simonschindler/E-Ink/Software/VSCODE/VMCB/src/Yosemite.png

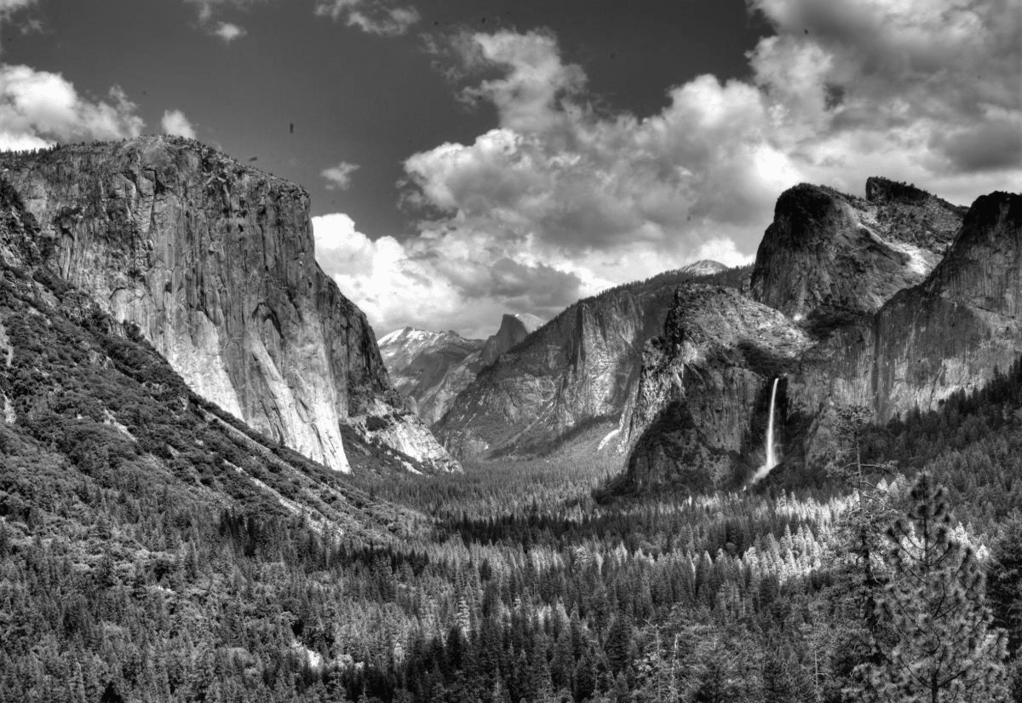
Software/VSCODE/VMCB/src/Yosemite.png
