simonschindler/E-Ink/Software/UML.png

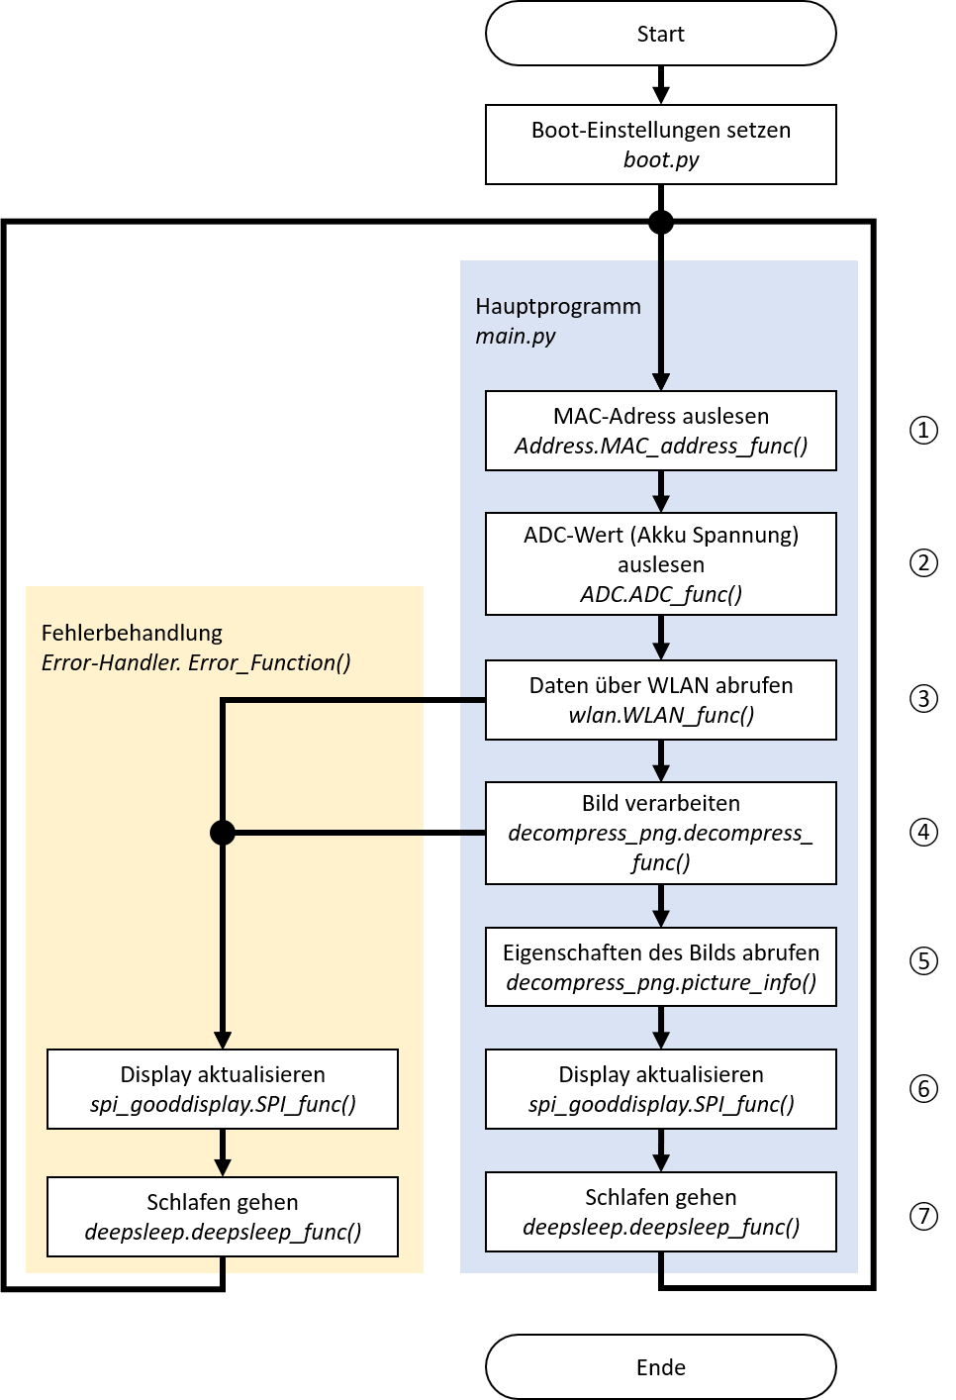
Software/UML.png
