simonschindler/E-Ink/Software/Wlan.png

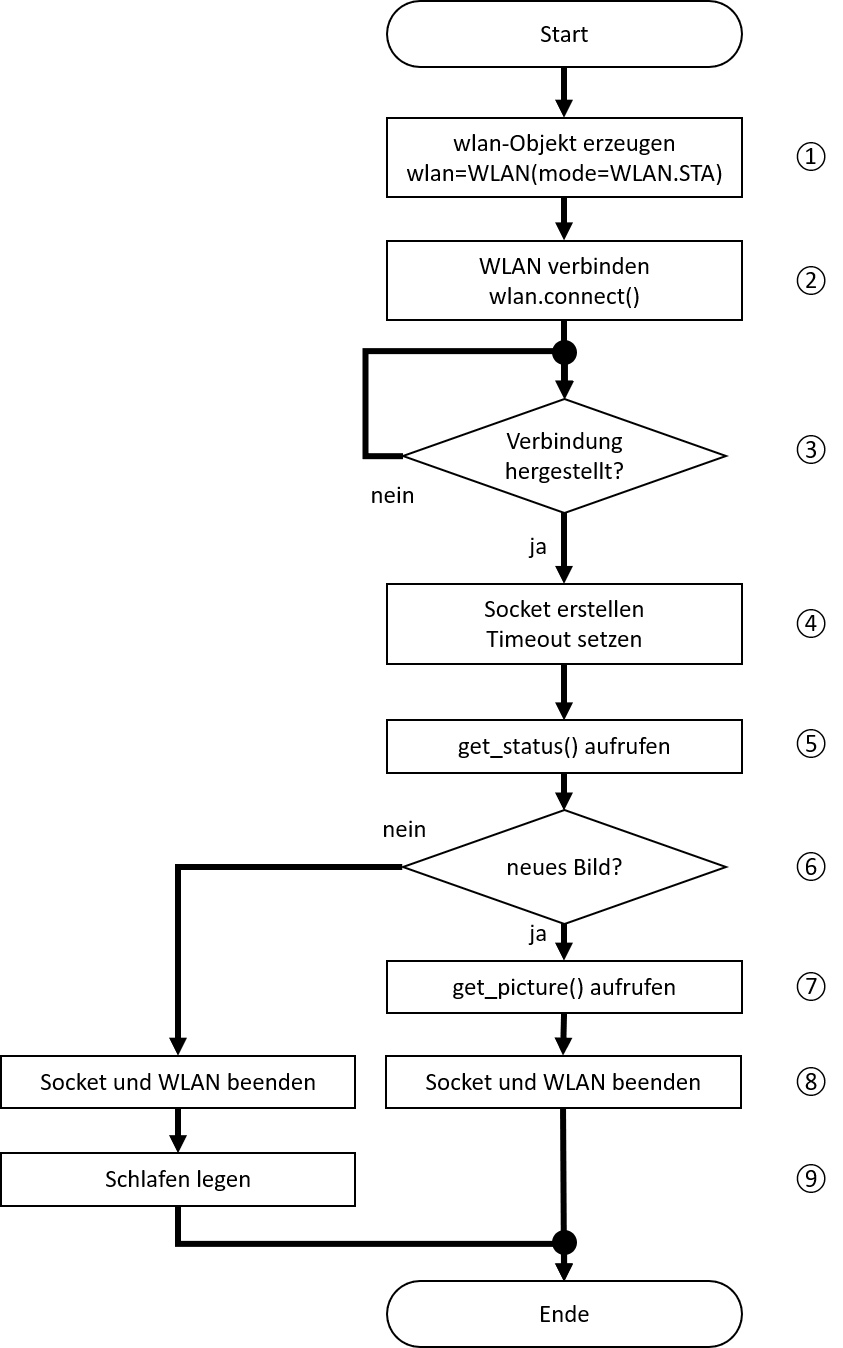
Software/Wlan.png
