simonschindler/E-Ink/Software/WlanSocket.png

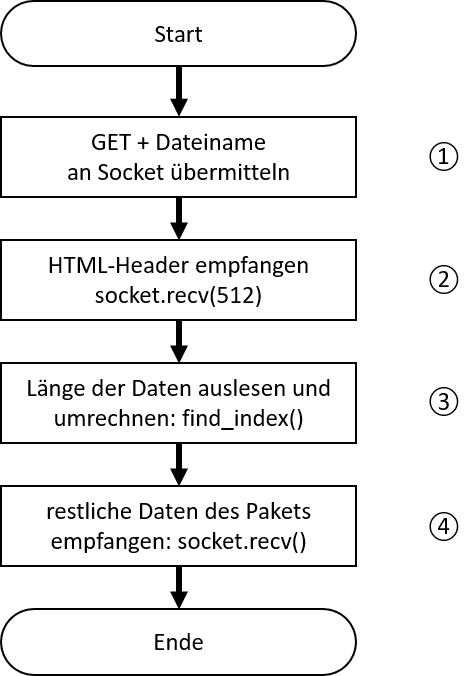
Software/WlanSocket.png
