simonschindler/E-Ink/Bestellliste.ods

Bauteilname | Distributor | Bestellnummer | Anzahl
ESP32-WROOM-32U | Digikey | 1904-1028-1-ND | 1
BuckBoost3V3 | Digikey | 296-39461-1-ND | 1
BuckBoost5V | Digikey | 296-19644-1-ND | 1
Spule 2.2 µH | Digikey | 490-15950-1-ND | 2
Level-Shifter | Digikey | 296-21929-1-ND | 1
Buchse zu E-Ink Driver | Digikey | 455-1755-1-ND | 1
Crimpkabel zu E-Ink Driver | Digikey | 455-3081-ND | 9
Stecker zu E-Ink Driver | Digikey | 455-1189-ND | 2
Button | Digikey | CW181-ND | 2
Transistor | Digikey | 1727-2921-1-ND | 1
Wifi-Antenne | Digikey | WM17566-ND | 1
Buchsenleiste | Digikey | S5438-ND | 2
für Gehäuse
Abstandshalter M3 Nylon (8,00mm) | Digikey | 36-25509-ND | 10
M3 Halbrundkopf Geschlitzt Nylon | Digikey | 36-29344-ND | 20
Battery Halter (offen) AA 3 Cell Drahtleitung - 6" (152,4mm) | Digikey | BH3AA-W-ND | 1
Battery Kontakt Lötöse | Digikey | 36-5223-ND | 2
Battery Kontaktfeder Lötöse | Digikey | 36-5201-ND | 2
Web-Kennung: |  | 307356988
Zugriffscode: |  | 91707
