simonschindler/E-Ink/Mechanics/Assembly.FCStd

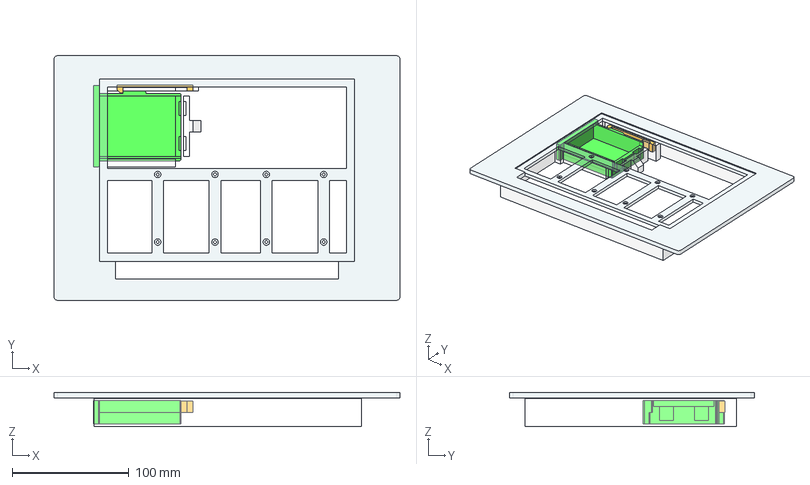
[picture p5: CAD file, 2020-03-20]
Mechanics/Assembly.FCStd
297.0 x 210.0 x 29.5 mm
Frontpanel_001
Verriegelungsstift_001
Batteriefach
Rückdeckel
