simonschindler/E-Ink/Hardware/E-Ink.step

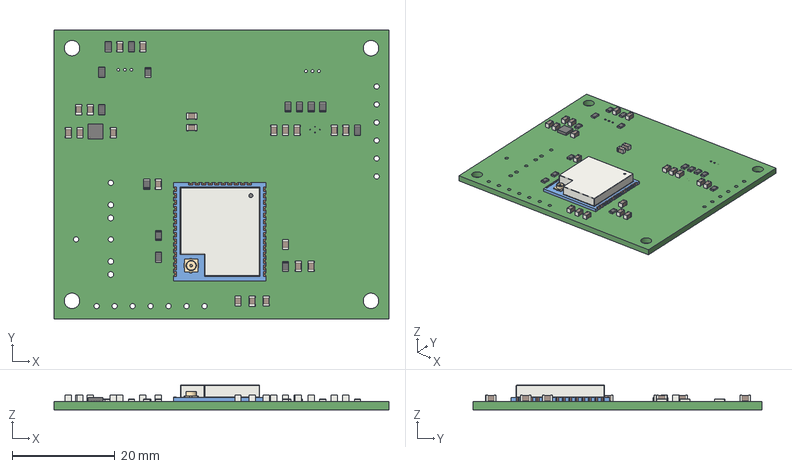
[picture p6: CAD file, 2019-12-15]
Hardware/E-Ink.step
65.2 x 56.2 x 4.85 mm
