simonschindler/E-Ink/Mechanics/Glasabdeckung.FCStd

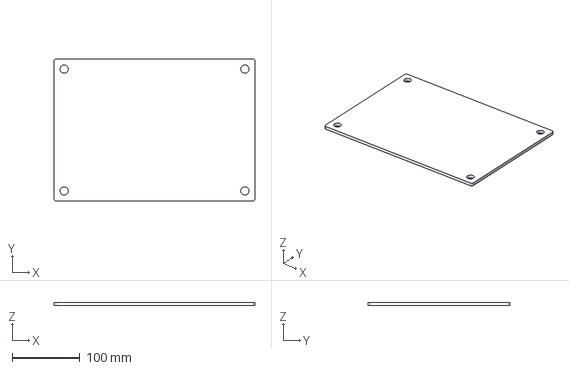
[picture p7: CAD file, 2020-12-21]
Mechanics/Glasabdeckung.FCStd
297.0 x 210.0 x 5.00 mm
