simonschindler/E-Ink/Mechanics/Wandhalterung_Zapfen.FCStd

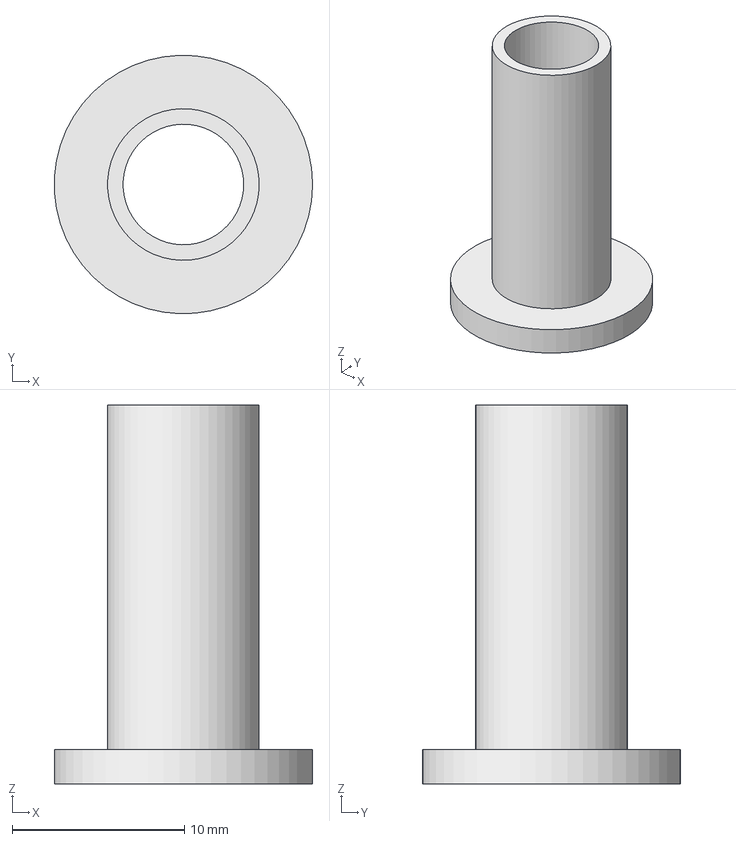
[picture p8: CAD file, 2020-12-18]
Mechanics/Wandhalterung_Zapfen.FCStd
15.0 x 15.0 x 22.0 mm
