simonschindler/E-Ink/Mechanics/Wandhalterung_Buchse.FCStd

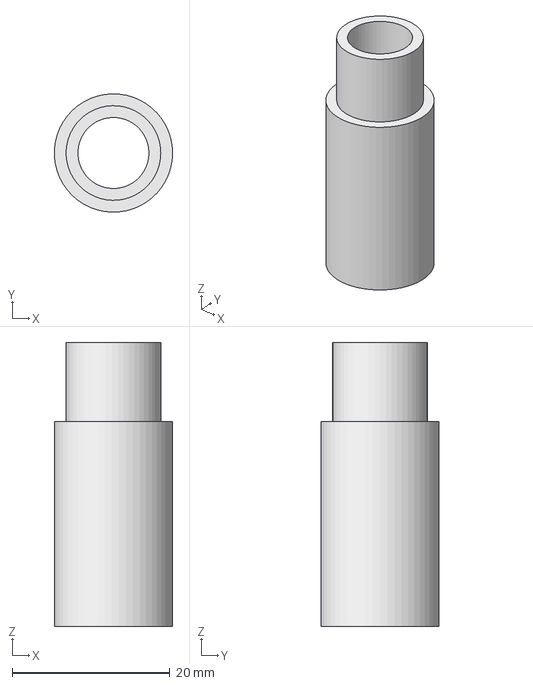
[picture p9: CAD file, 2020-12-18]
Mechanics/Wandhalterung_Buchse.FCStd
15.0 x 15.0 x 36.0 mm
