simonschindler/E-Ink/Mechanics/Frontpanel.FCStd

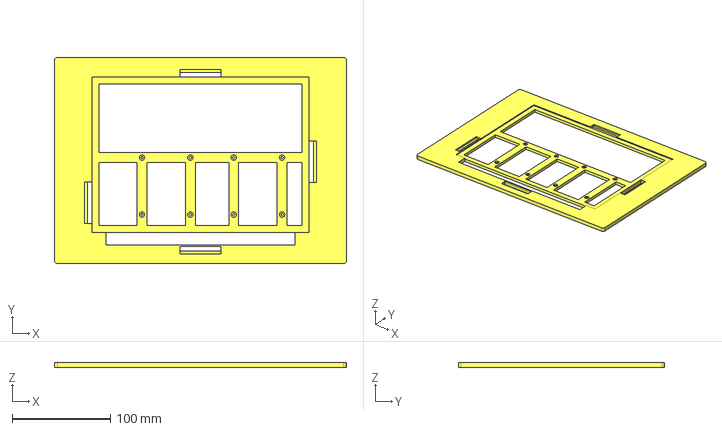
[picture p10: CAD file, 2020-07-03]
Mechanics/Frontpanel.FCStd
297.0 x 210.0 x 5.00 mm
