simonschindler/E-Ink/Mechanics/Rückdeckel.FCStd

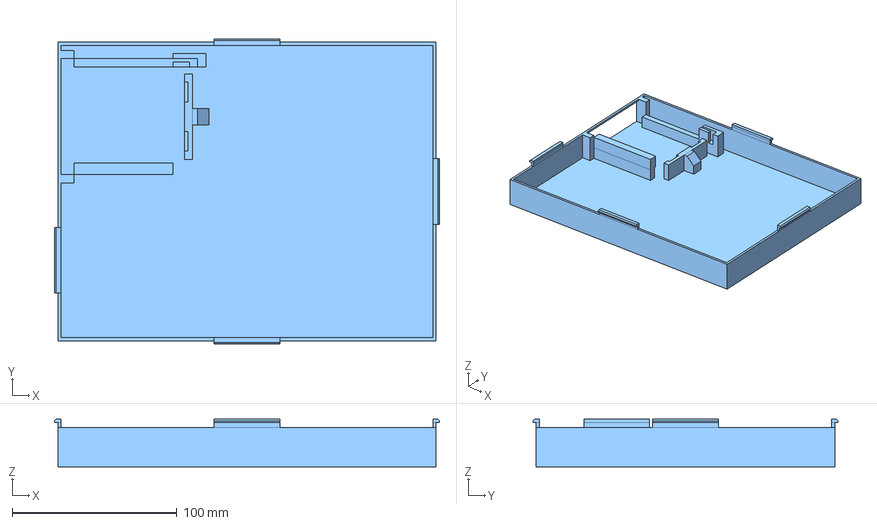
[picture p11: CAD file, 2020-05-02]
Mechanics/Rückdeckel.FCStd
234.0 x 185.5 x 29.0 mm
