simonschindler/E-Ink/Mechanics/Verriegelungsstift.FCStd

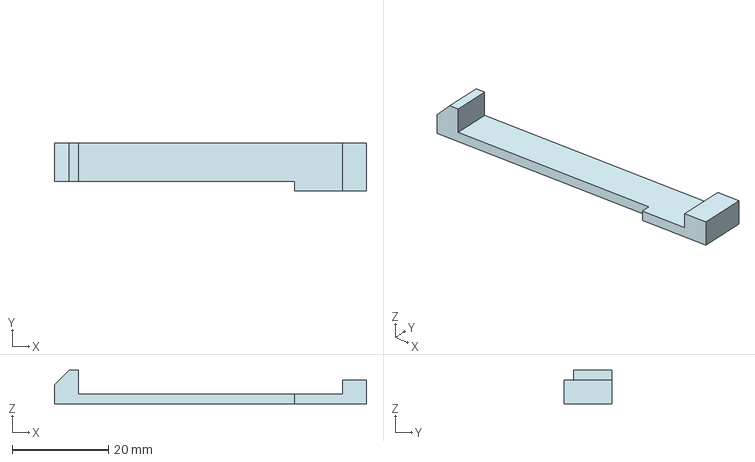
[picture p12: CAD file, 2020-05-02]
Mechanics/Verriegelungsstift.FCStd
65.0 x 10.0 x 7.00 mm
