simonschindler/E-Ink/Mechanics/Testaufbau montiert.FCStd

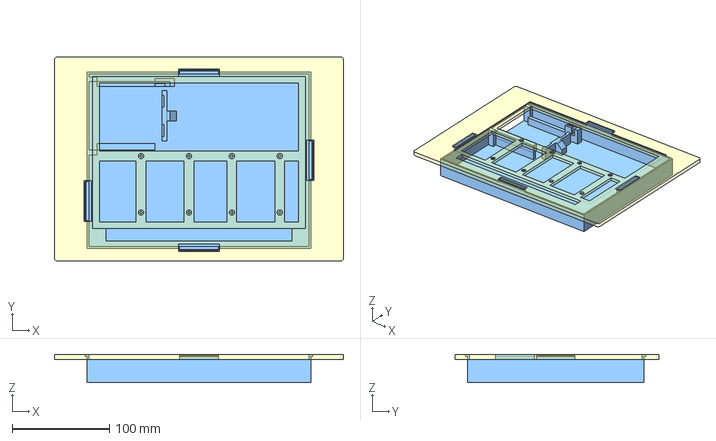
[picture p13: CAD file, 2020-05-02]
Mechanics/Testaufbau montiert.FCStd
297.0 x 210.0 x 29.0 mm
Grundmaße
