simonschindler/E-Ink/Mechanics/Testdeckel.FCStd

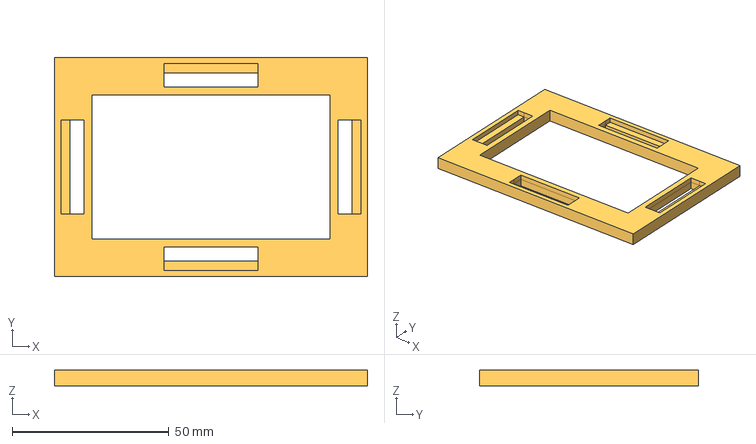
[picture p14: CAD file, 2020-03-20]
Mechanics/Testdeckel.FCStd
100.0 x 70.0 x 5.00 mm
