simonschindler/E-Ink/Mechanics/Testrückdeckel.FCStd

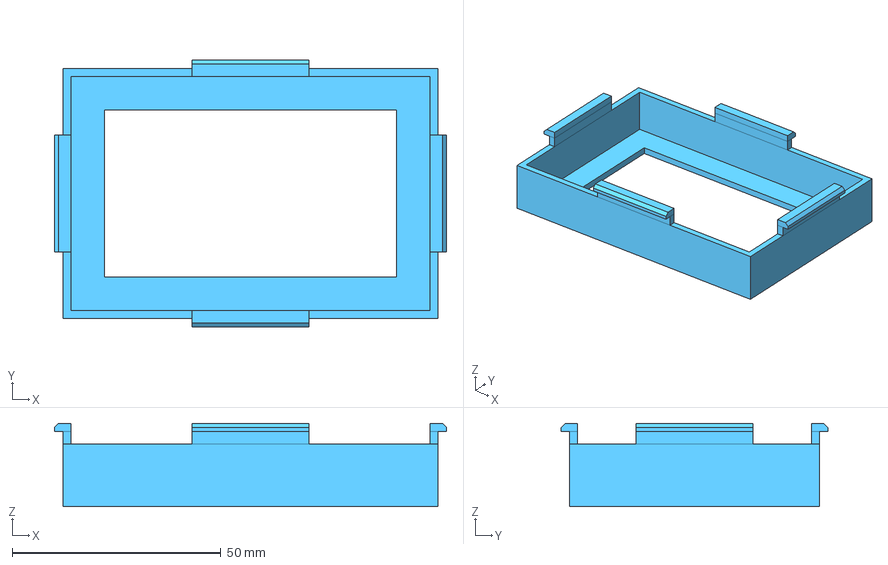
[picture p15: CAD file, 2020-03-20]
Mechanics/Testrückdeckel.FCStd
94.0 x 64.0 x 20.0 mm
