simonschindler/E-Ink/Mechanics/Batteriefach.FCStd

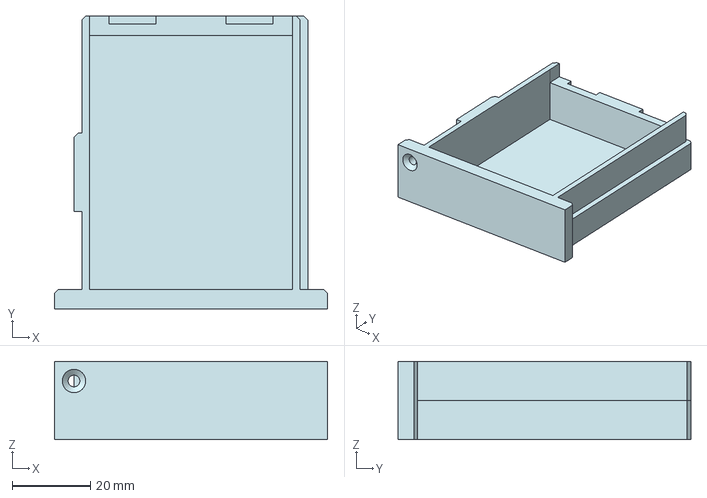
[picture p16: CAD file, 2020-03-20]
Mechanics/Batteriefach.FCStd
70.0 x 75.0 x 20.0 mm
