simonschindler/E-Ink/Errata_Platine.xlsx

Problembeschreibung | Bauteil | Lösung | Änderungsvorschlag
Levelshifter war unnötig, da IT8951 mit 3V3 Logik arbeitet | SPI-Levelshifter U501 | Levelshifter nicht bestücken, Verbindungen überbrücken | Levelshifter weglassen, Verbindungen durchziehen
Transistorschaltung funktioniert nicht, Ohne Transistor lässt sich der Eingang auch Enablen | Transistor Q201 | Transisitor entfernen, R201 u R202 kurzschließen | Transistor entfernen, EN direkt durchführen
Transistorschaltung funktioniert nicht | Transistor Q301 | Transisitor, R301 u R302 entfernen, R303 u R304 zur Stromsparenden Spannungsmessung mit 2.5 MegOhm bestücken | Transisitor, R301 u R302 entfernen, R303 u R304 zur Stromsparenden Spannungsmessung mit 2.5 MegOhm bestücken
