simonschindler/E-Ink/Hardware/E-Ink.kicad_pcb

## KiCad design Hardware/E-Ink.kicad_pcb (2020-12-18)

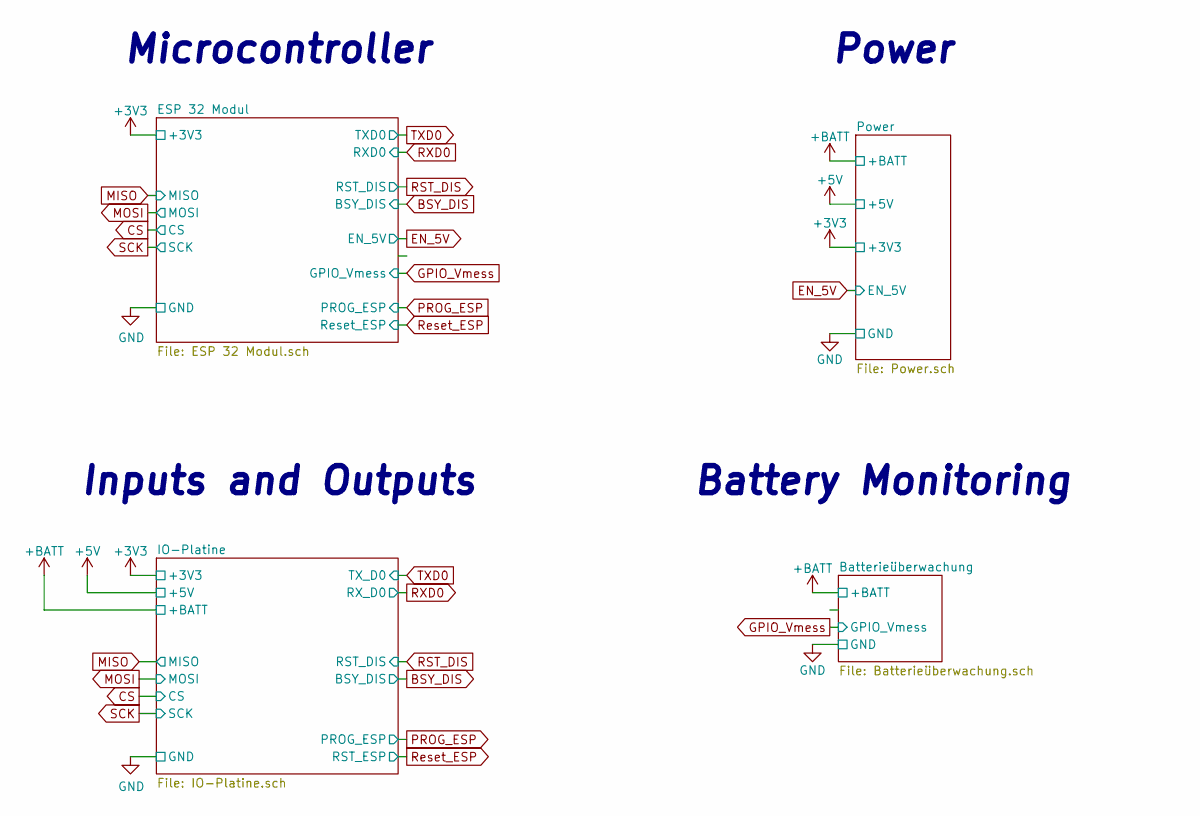
[picture p17: schematic E-Ink.sch, E-Ink-Parkplatzanzeige]

Notes on the sheet:
Microcontroller
Power
Inputs and Outputs
Battery Monitoring

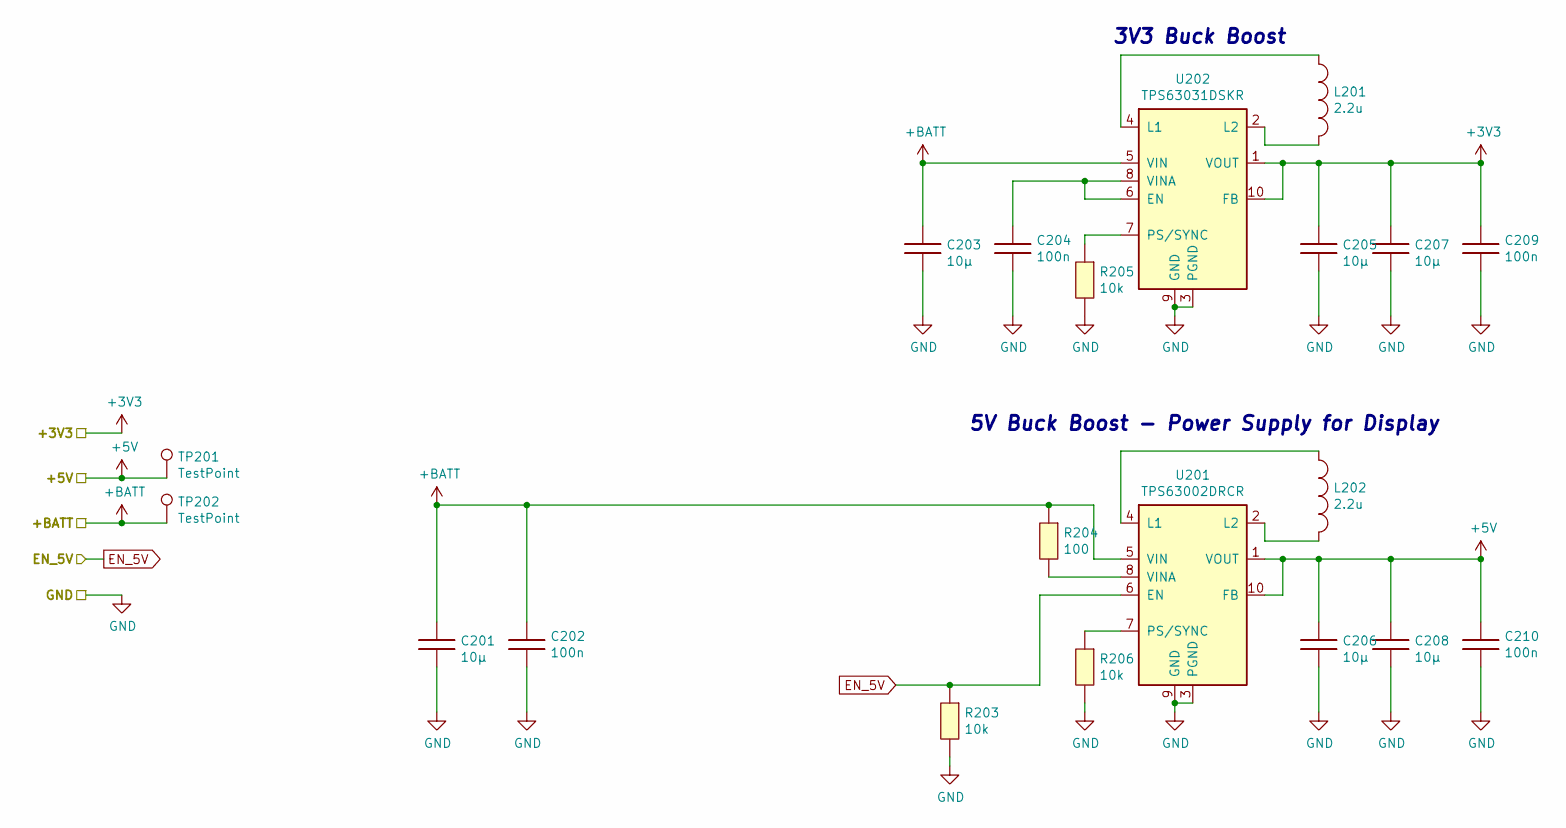
[picture p18: schematic Power.sch, E-Ink-Parkplatzanzeige]

Parts:
C201, C203, C205, C206, C207, C208: 10µ; C_0805_2012Metric_Pad1.15x1.40mm_HandSolder
C202, C204, C209, C210: 100n; C_0805_2012Metric_Pad1.15x1.40mm_HandSolder
L201, L202: 2.2u; L_Taiyo-Yuden_MD-3030; Digi-Key_PN 490-15950-1-ND
R203, R205, R206: 10k; R_0805_2012Metric_Pad1.15x1.40mm_HandSolder
R204: 100; R_0805_2012Metric_Pad1.15x1.40mm_HandSolder
TP201, TP202: TestPoint; Test_Point_D1.02mm; Digi-Key_PN 36-5001-ND
U201: TPS63002DRCR; Texas_DRC0010J_ThermalVias; Digi-Key_PN 296-19644-1-ND
U202: TPS63031DSKR; WSON-8-1EP_3x3mm_P0.5mm_EP1.6x2.0mm; Digi-Key_PN 296-39461-1-ND

Connections:
+3V3: C205.1, C207.1, C209.1, U202.1 (VOUT), U202.10 (FB); also elsewhere on the board
+5V: C206.1, C208.1, C210.1, TP201.1, U201.1 (VOUT), U201.10 (FB); also elsewhere on the board
+BATT: C201.1, C202.1, C203.1, R204.1, TP202.1, U201.5 (VIN), U202.5 (VIN); also elsewhere on the board
EN_5V: R203.1, U201.6 (EN); also elsewhere on the board
GND: C201.2, C202.2, C203.2, C204.2, C205.2, C206.2, C207.2, C208.2, C209.2, C210.2, R203.2, R205.2, R206.2, U201.3 (PGND), U201.9 (GND), U201.11 (PGND), U202.3 (PGND), U202.9 (GND), U202.11 (PGND); also elsewhere on the board
unnamed: C204.1, U202.6 (EN), U202.8 (VINA)
unnamed: L201.1, U202.4 (L1)
unnamed: L201.2, U202.2 (L2)
unnamed: L202.1, U201.4 (L1)
unnamed: L202.2, U201.2 (L2)
unnamed: R204.2, U201.8 (VINA)
unnamed: R205.1, U202.7 (PS/SYNC)
unnamed: R206.1, U201.7 (PS/SYNC)

Notes on the sheet:
3V3 Buck Boost
5V Buck Boost - Power Supply for Display

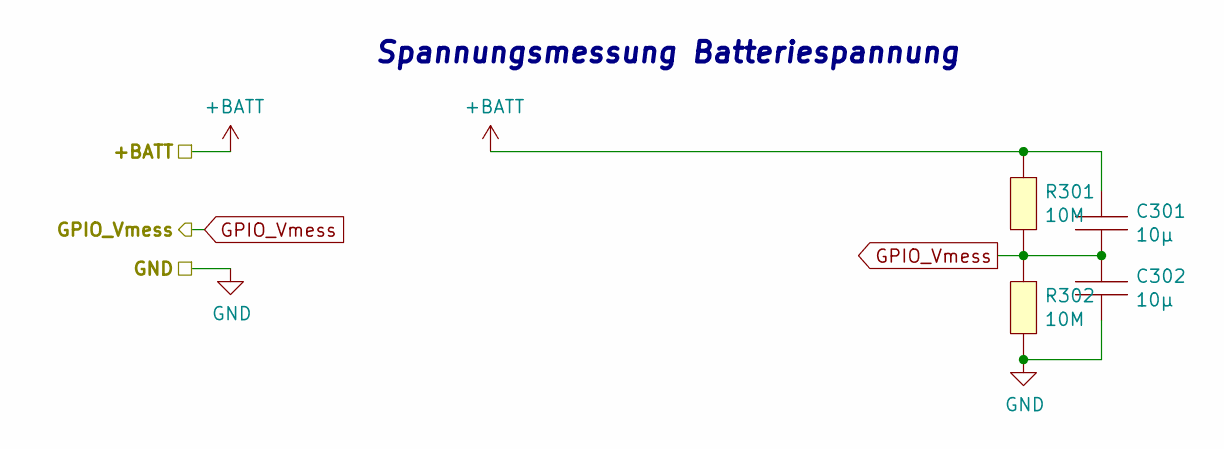
[picture p19: schematic Batterieüberwachung.sch, E-Ink-Parkplatzanzeige]

Parts:
C301, C302: 10µ; C_0805_2012Metric_Pad1.15x1.40mm_HandSolder
R301, R302: 10M; R_0805_2012Metric_Pad1.20x1.40mm_HandSolder

Connections:
+BATT: C301.1, R301.2; also elsewhere on the board
GND: C302.2, R302.2; also elsewhere on the board
GPIO_Vmess: C301.2, C302.1, R301.1, R302.1; also elsewhere on the board

Notes on the sheet:
Spannungsmessung Batteriespannung

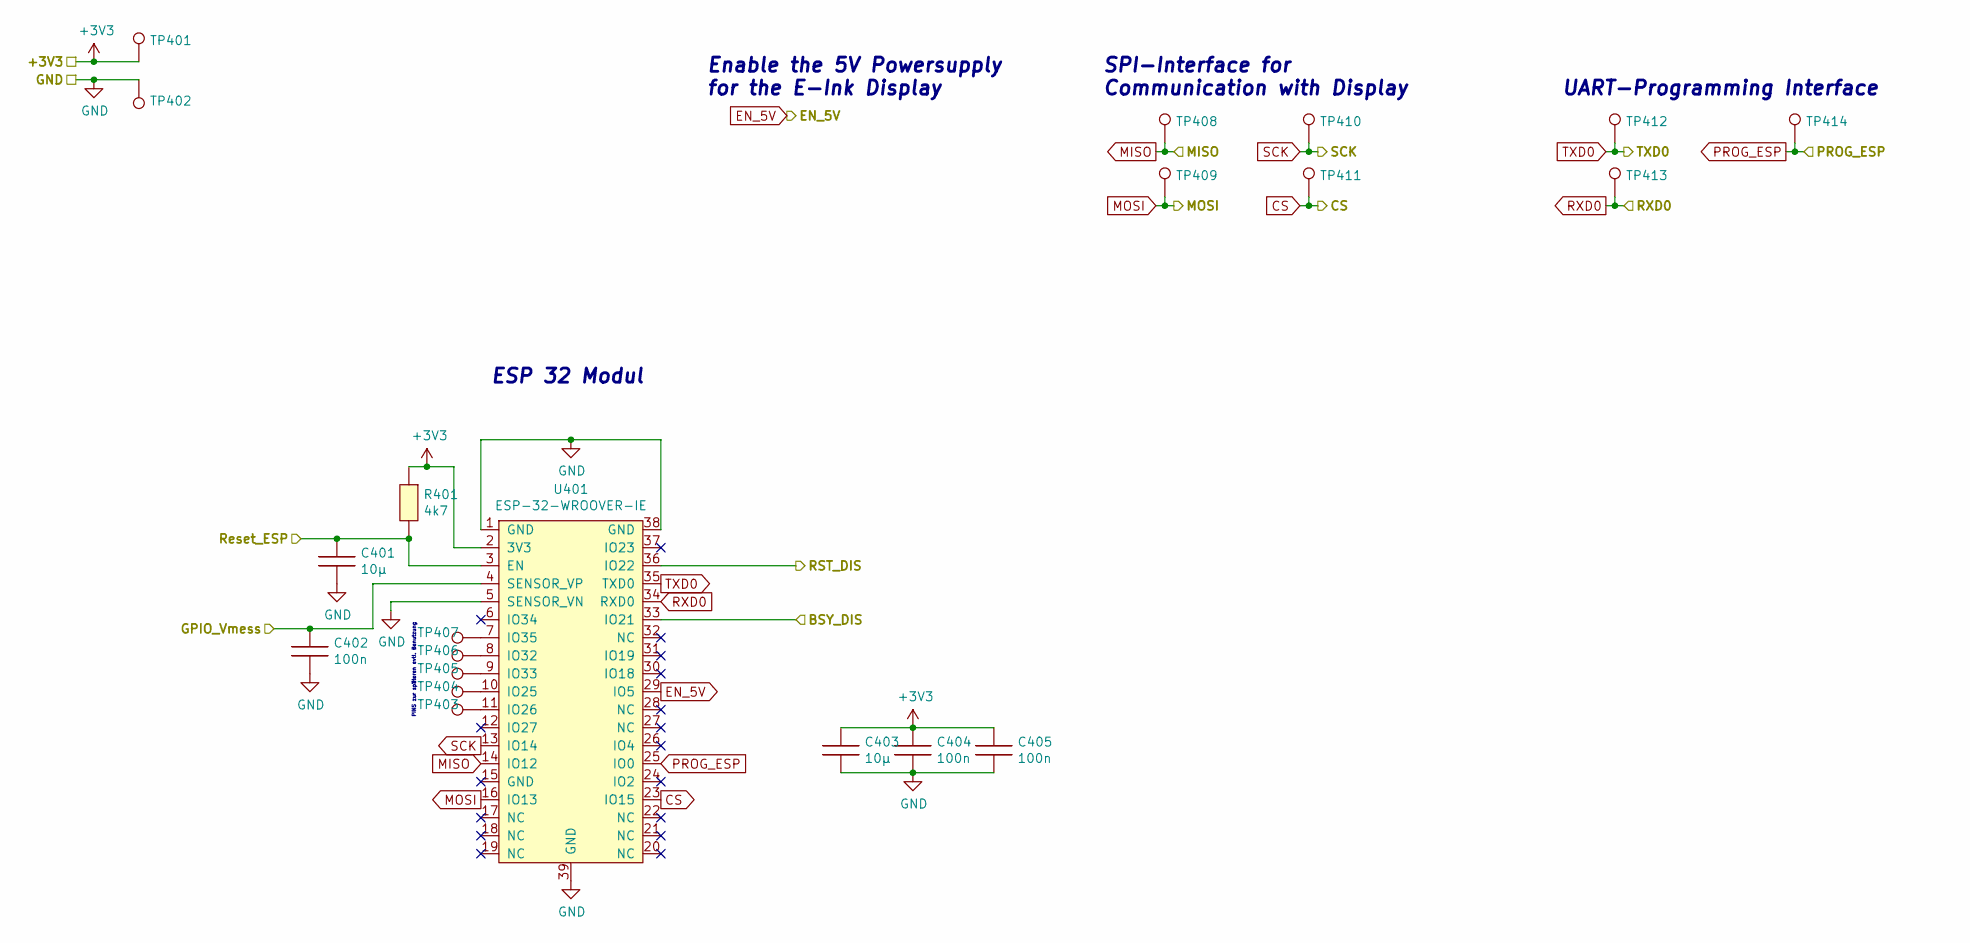
[picture p20: schematic ESP 32 Modul.sch, E-Ink-Parkplatzanzeige]

Parts:
C401, C403: 10µ; C_0805_2012Metric_Pad1.15x1.40mm_HandSolder
C402, C404, C405: 100n; C_0805_2012Metric_Pad1.15x1.40mm_HandSolder
R401: 4k7; R_0805_2012Metric_Pad1.15x1.40mm_HandSolder
TP401, TP402, TP403, TP404, TP405, TP406, TP407, TP408, TP409, TP410, TP411, TP412, TP413, TP414: TestPoint; Test_Point_D1.02mm; Digi-Key_PN 36-5001-ND
U401: ESP-32-WROOVER-IE; ESP32-WROVER

Connections:
+3V3: C403.1, C404.1, C405.1, R401.1, TP401.1, U401.2 (3V3); also elsewhere on the board
BSY_DIS: U401.33 (IO21); also elsewhere on the board
CS: TP411.1, U401.23 (IO15); also elsewhere on the board
EN_5V: U401.29 (IO5); also elsewhere on the board
GND: C401.2, C402.2, C403.2, C404.2, C405.2, TP402.1, U401.1 (GND), U401.5 (SENSOR_VN), U401.38 (GND), U401.39 (GND); also elsewhere on the board
GPIO_Vmess: C402.1, U401.4 (SENSOR_VP); also elsewhere on the board
MISO: TP408.1, U401.14 (IO12); also elsewhere on the board
MOSI: TP409.1, U401.16 (IO13); also elsewhere on the board
unnamed: TP403.1, U401.11 (IO26)
unnamed: TP404.1, U401.10 (IO25)
unnamed: TP405.1, U401.9 (IO33)
unnamed: TP406.1, U401.8 (IO32)
unnamed: TP407.1, U401.7 (IO35)
PROG_ESP: TP414.1, U401.25 (IO0); also elsewhere on the board
RST_DIS: U401.36 (IO22); also elsewhere on the board
RST_ESP: C401.1, R401.2, U401.3 (EN); also elsewhere on the board
RXD0: TP413.1, U401.34 (RXD0); also elsewhere on the board
SCK: TP410.1, U401.13 (IO14); also elsewhere on the board
TXD0: TP412.1, U401.35 (TXD0); also elsewhere on the board

Notes on the sheet:
ESP 32 Modul
UART-Programming Interface
SPI-Interface for Communication with Display
Enable the 5V Powersupply for the E-Ink Display
PINS zur späteren evtl. Benutzung

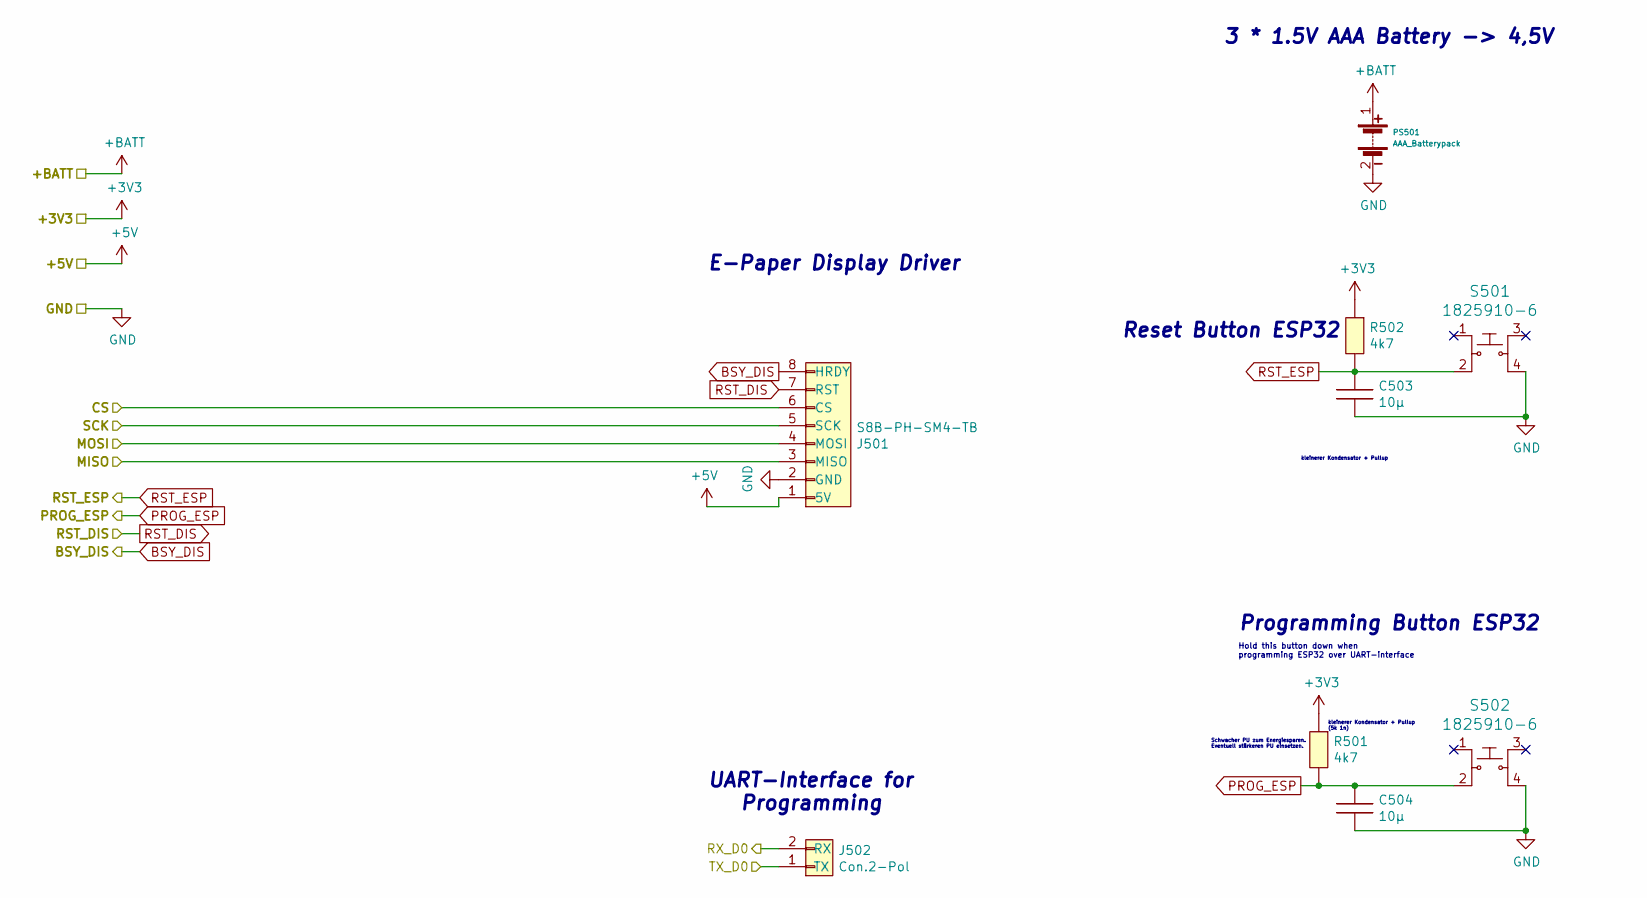
[picture p21: schematic IO-Platine.sch, E-Ink-Parkplatzanzeige]

Parts:
C503, C504: 10µ; C_0805_2012Metric_Pad1.15x1.40mm_HandSolder
J501: S8B-PH-SM4-TB; Digi-Key_PN 455-1755-1-ND
J502: Con.2-Pol; Pin-Header_1x2_2.54mm; Digi-Key_PN S5438-ND
PS501: AAA_Batterypack; Pin-Header_1x2_2.54mm
R501: 4k7; R_0805_2012Metric_Pad1.15x1.40mm_HandSolder
R502: 4k7; R_0805_2012Metric_Pad1.20x1.40mm_HandSolder
S501, S502: 1825910-6; Switch_Tactile_SMD_6x6mm; MPN 1825910-6; Digi-Key_PN 450-1650-ND

Connections:
+3V3: R501.1, R502.1; also elsewhere on the board
+5V: J501.1 (5V); also elsewhere on the board
+BATT: PS501.1; also elsewhere on the board
BSY_DIS: J501.8 (HRDY); also elsewhere on the board
CS: J501.6 (CS); also elsewhere on the board
GND: C503.2, C504.2, J501.2 (GND), PS501.2, S501.4, S502.4; also elsewhere on the board
MISO: J501.3 (MISO); also elsewhere on the board
MOSI: J501.4 (MOSI); also elsewhere on the board
PROG_ESP: C504.1, R501.2, S502.2; also elsewhere on the board
RST_DIS: J501.7 (RST); also elsewhere on the board
RST_ESP: C503.1, R502.2, S501.2; also elsewhere on the board
RXD0: J502.2 (RX); also elsewhere on the board
SCK: J501.5 (SCK); also elsewhere on the board
TXD0: J502.1 (TX); also elsewhere on the board

Notes on the sheet:
Reset Button ESP32
Programming Button ESP32
Schwacher PU zum Energiesparen. Eventuell stärkeren PU einsetzen.
Hold this button down when programming ESP32 over UART-interface
E-Paper Display Driver
3 * 1.5V AAA Battery -> 4,5V
UART-Interface for Programming
kleinerer Kondensator + Pullup
kleinerer Kondensator + Pullup (5k 1n)

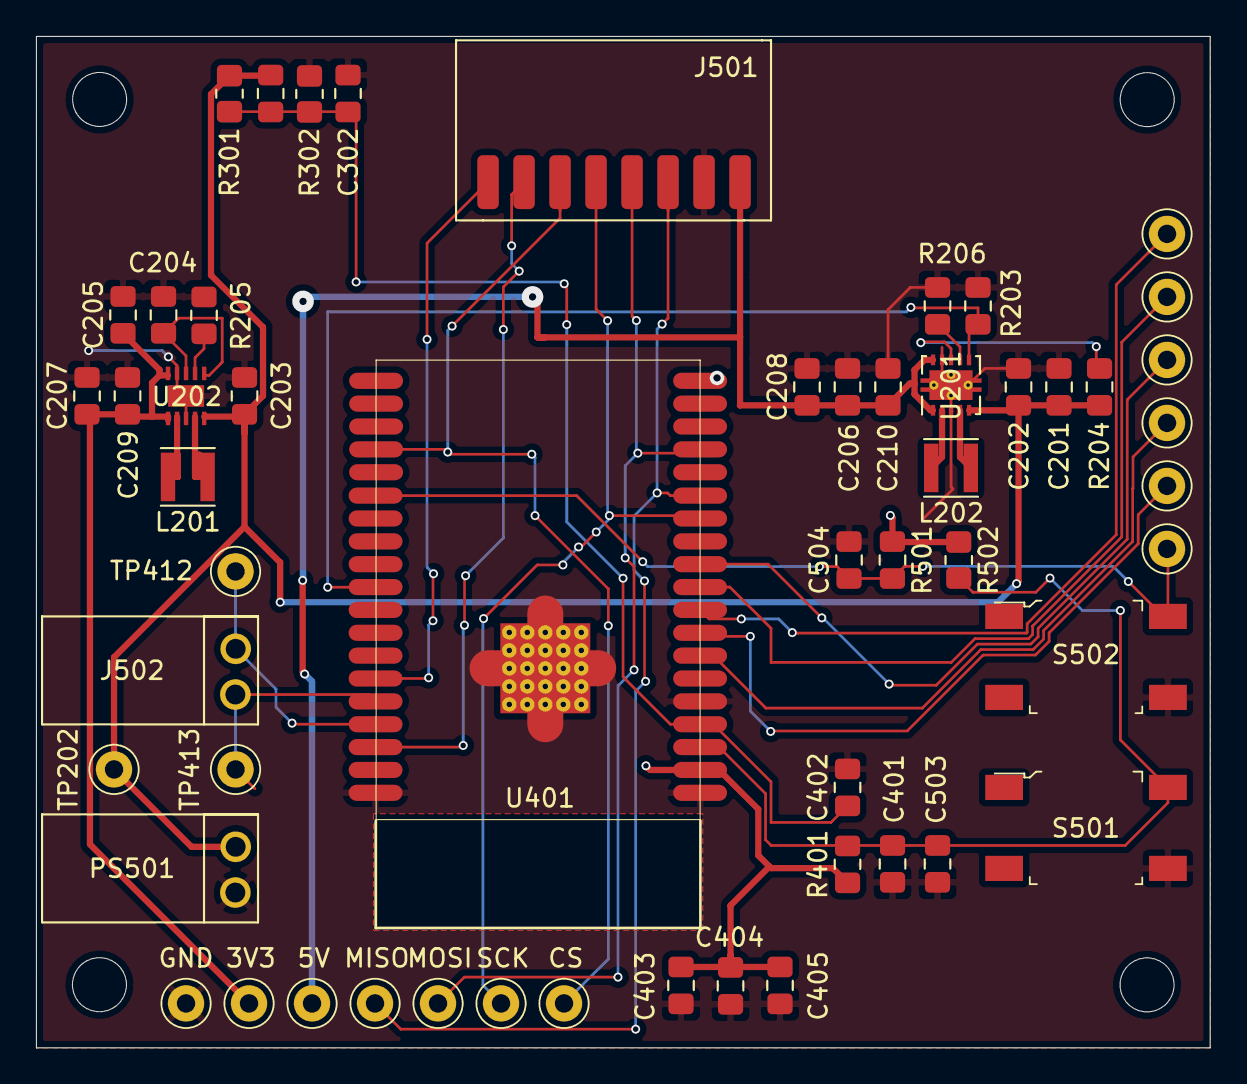
[picture p22: board E-Ink.kicad_pcb from above]

Board: 2 copper layers, 65.2 x 56.2 mm, 54 parts (0 on the bottom side), 29 nets.
