simonschindler/E-Ink/Pavel/Tuerschild_Boarddesign.kicad_pcb

## KiCad design Pavel/Tuerschild_Boarddesign.kicad_pcb (2019-11-27)

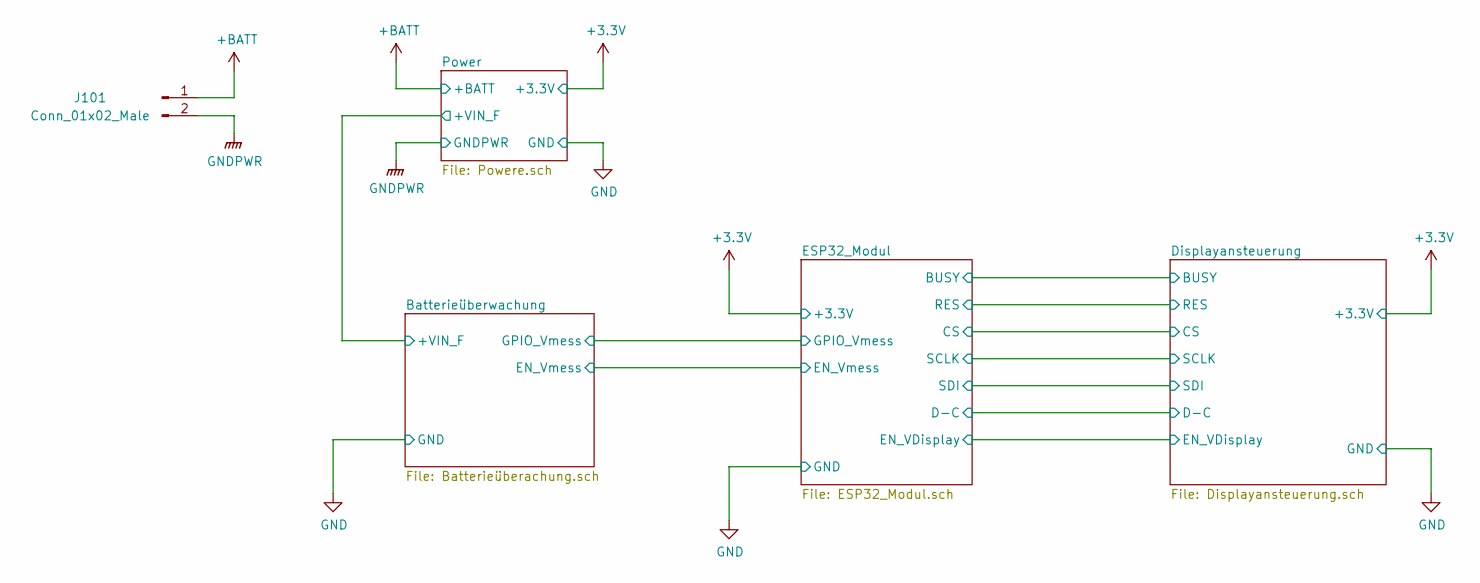
[picture p23: schematic Tuerschild_Boarddesign.sch]

Parts:
J101: Conn_01x02_Male; Batterieeinspeisungspads

Connections:
+BATT: J101.1; also elsewhere on the board
GNDPWR: J101.2; also elsewhere on the board

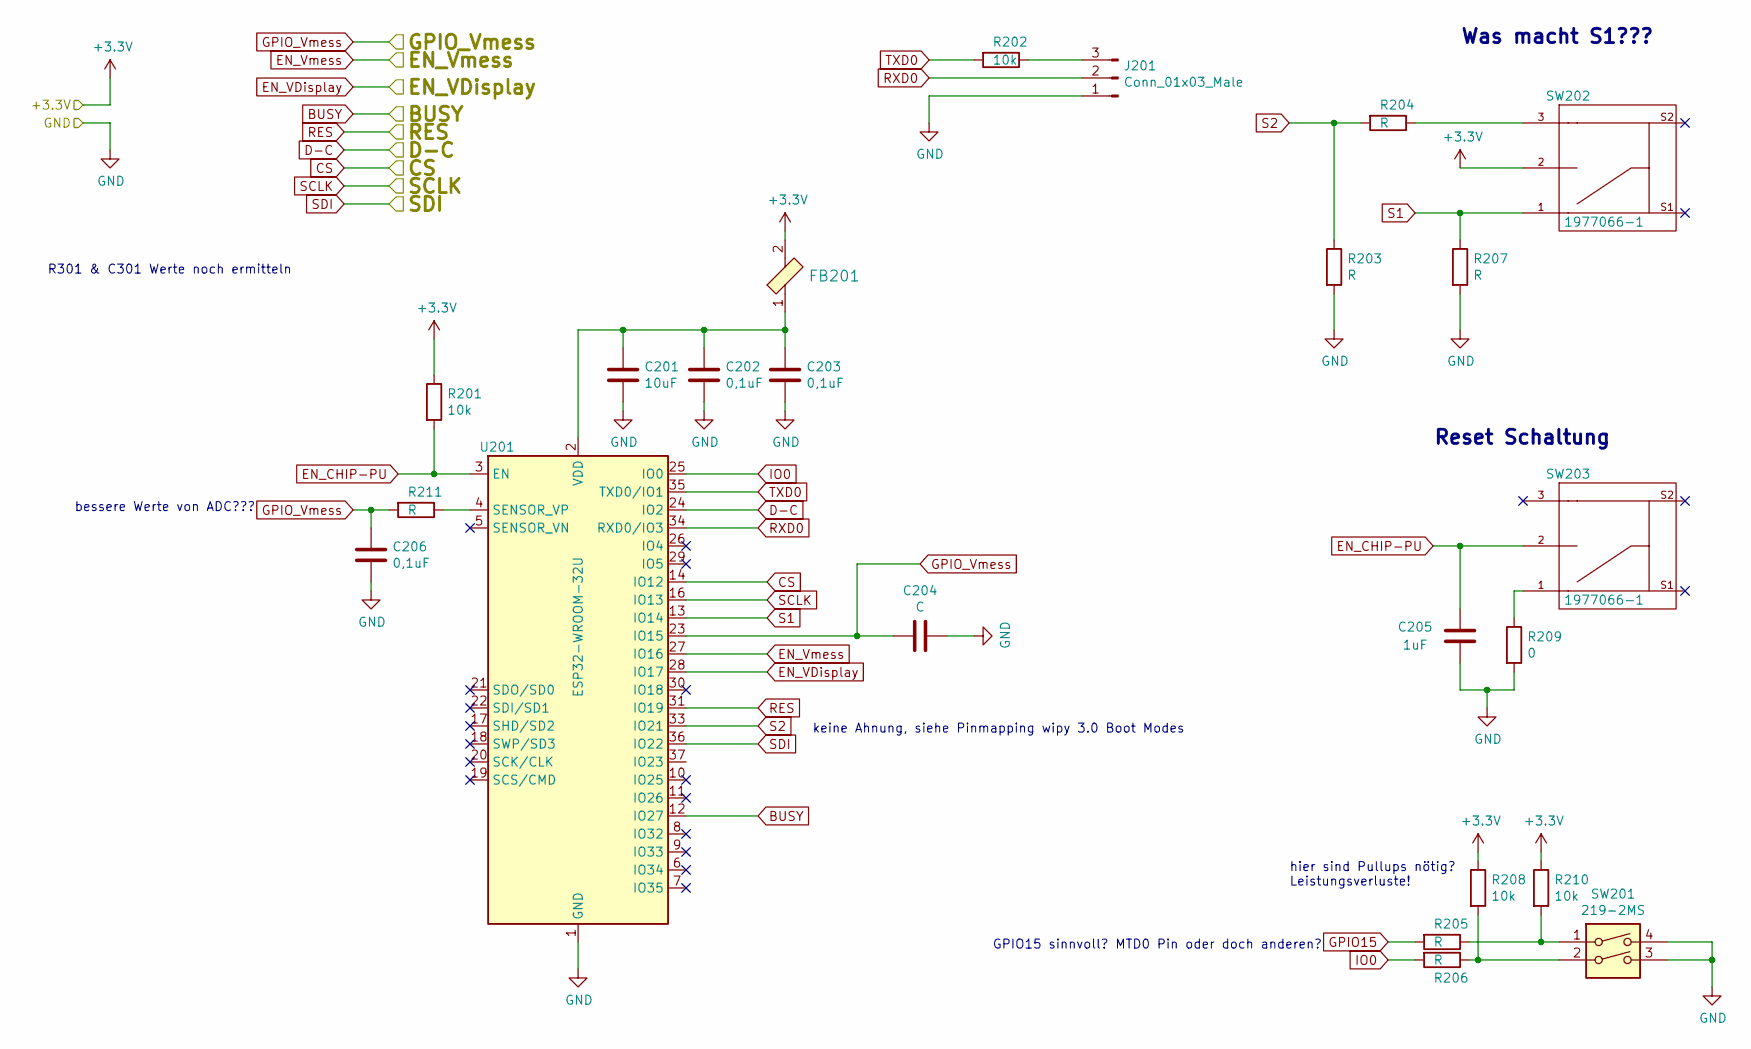
[picture p24: schematic ESP32_Modul.sch]

Parts:
C201: 10uF; C_0603_1608Metric
C202, C203, C206: 0,1uF; C_0603_1608Metric
C204: C; C_0603_1608Metric
C205: 1uF; C_0603_1608Metric
FB201: 742792641; 0603; MPN 742792641; Digi-Key_PN 732-1592-2-ND
J201: Conn_01x03_Male; FanPinHeader_1x03_P2.54mm_Vertical
R201, R202, R208, R210: 10k; R_0603_1608Metric_Pad1.05x0.95mm_HandSolder
R203, R204, R205, R206, R207, R211: R; R_0603_1608Metric_Pad1.05x0.95mm_HandSolder
R209: 0; R_0603_1608Metric_Pad1.05x0.95mm_HandSolder
SW201: 219-2MS; SW_DIP_SPSTx02_Slide_6.7x6.64mm_W8.61mm_P2.54mm_LowProfile
SW202, SW203: 1977066-1; TE_1977066-1
U201: ESP32-WROOM-32U

Connections:
+3V3: FB201.2, R201.1, R208.1, R210.1, SW202.2; also elsewhere on the board
BUSY: U201.12 (IO27); also elsewhere on the board
CS: U201.14 (IO12); also elsewhere on the board
D-C: U201.24 (IO2); also elsewhere on the board
EN_CHIP-PU: C205.2, R201.2, SW203.2, U201.3 (EN)
EN_VDisplay: U201.28 (IO17); also elsewhere on the board
EN_Vmess: U201.27 (IO16); also elsewhere on the board
GND: C201.2, C202.2, C203.2, C204.1, C205.1, C206.2, J201.1, R203.2, R207.2, R209.2, SW201.3, SW201.4, U201.1 (GND), U201.15 (GND), U201.38 (GND); also elsewhere on the board
GPIO15: R205.2
GPIO_Vmess: C204.2, C206.1, R211.2, U201.23 (IO15); also elsewhere on the board
IO0: R206.2, U201.25 (IO0)
unnamed: C201.1, C202.1, C203.1, FB201.1, U201.2 (VDD)
unnamed: J201.3, R202.1
unnamed: R204.1, SW202.3 (1)
unnamed: R205.1, R210.2, SW201.1
unnamed: R206.1, R208.2, SW201.2
unnamed: R209.1, SW203.1
unnamed: R211.1, U201.4 (SENSOR_VP)
RES: U201.31 (IO19); also elsewhere on the board
RXD0: J201.2, U201.34 (RXD0/IO3)
S1: R207.1, SW202.1, U201.13 (IO14)
S2: R203.1, R204.2, U201.33 (IO21)
SCLK: U201.16 (IO13); also elsewhere on the board
SDI: U201.36 (IO22); also elsewhere on the board
TXD0: R202.2, U201.35 (TXD0/IO1)

Notes on the sheet:
R301 & C301 Werte noch ermitteln
Reset Schaltung
Was macht S1???
hier sind Pullups nötig? Leistungsverluste!
keine Ahnung, siehe Pinmapping wipy 3.0 Boot Modes
bessere Werte von ADC???
GPIO15 sinnvoll? MTD0 Pin oder doch anderen?

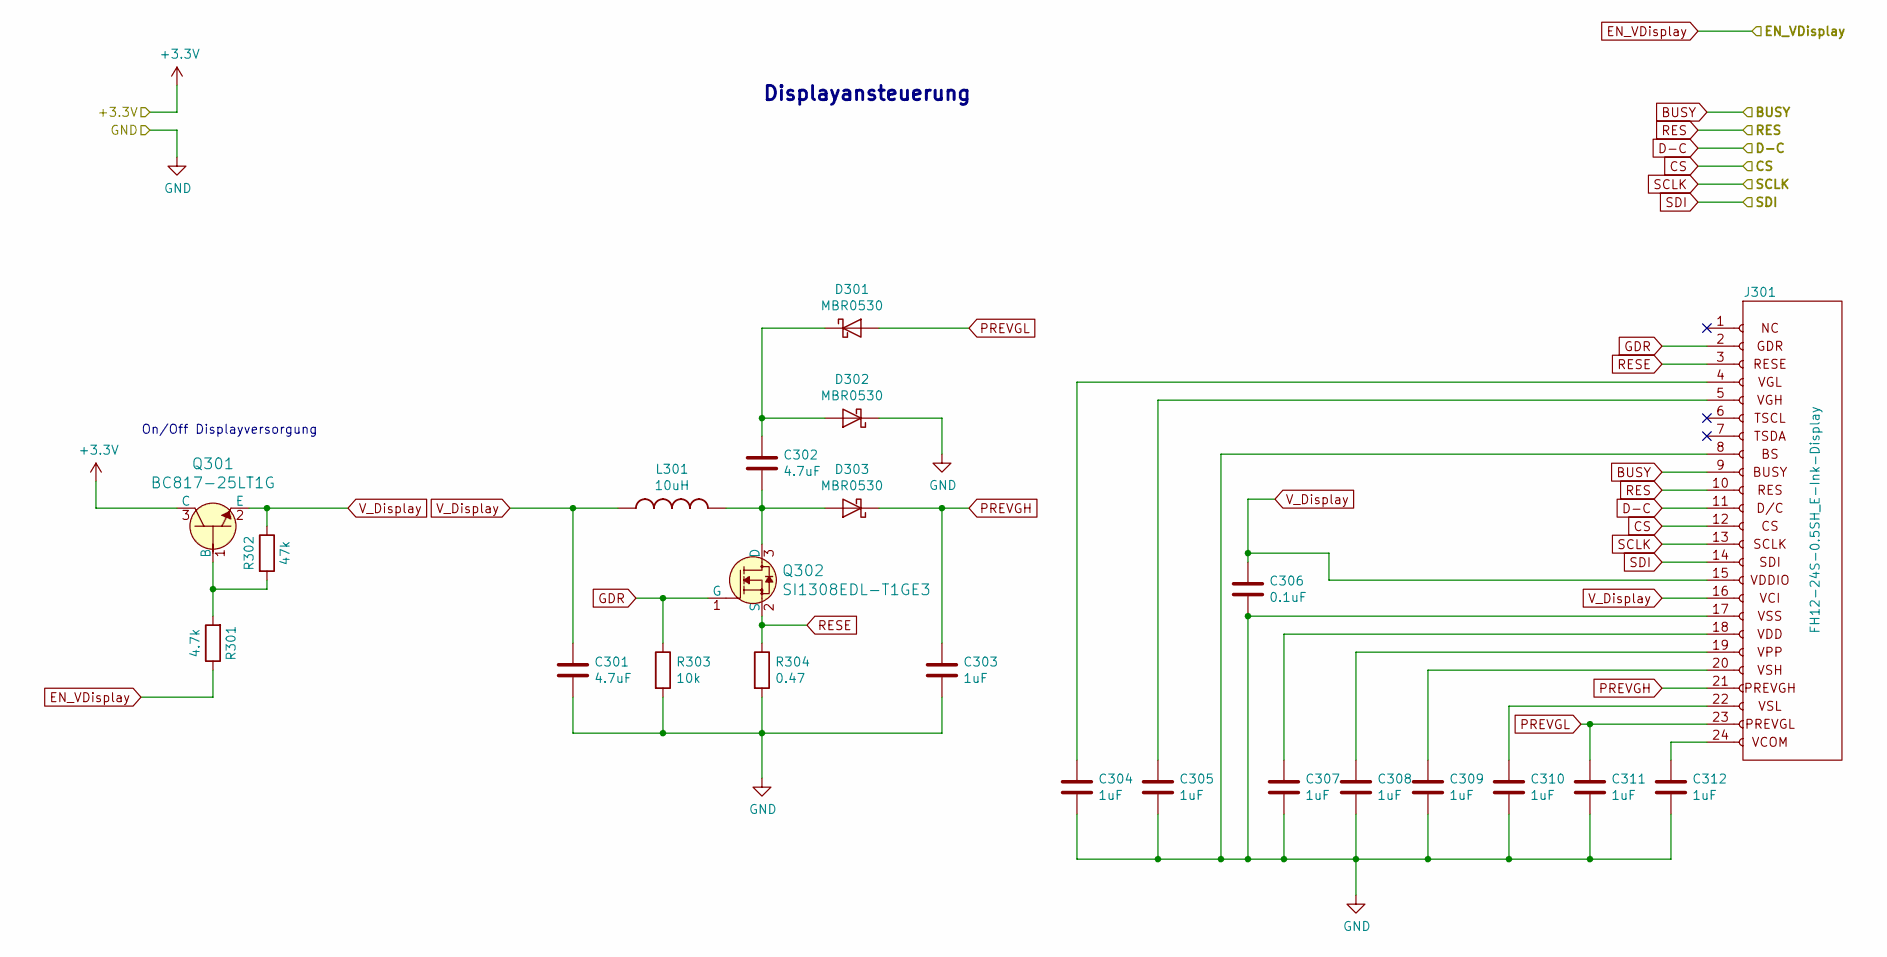
[picture p25: schematic Displayansteuerung.sch]

Parts:
C301, C302: 4.7uF; C_0603_1608Metric
C303, C304, C305, C307, C308, C309, C310, C311, C312: 1uF; C_0603_1608Metric
C306: 0.1uF; C_0603_1608Metric
D301, D302, D303: MBR0530; D_SOD-123
J301: FH12-24S-0.5SH_E-Ink-Display; Hirose_FH12-24S-0.5SH_1x24-1MP_P0.50mm_Horizontal
L301: 10uH; NLCV32-EF
Q301: BC817-25LT1G; SOT-23; MPN BC817-25LT1G; Digi-Key_PN BC817-25LT1GOSCT-ND
Q302: SI1308EDL-T1GE3; SOT-323_SC-70; MPN SI1308EDL-T1-GE3; Digi-Key_PN SI1308EDL-T1-GE3CT-ND
R301: 4.7k; R_0603_1608Metric_Pad1.05x0.95mm_HandSolder
R302: 47k; R_0603_1608Metric_Pad1.05x0.95mm_HandSolder
R303: 10k; R_0603_1608Metric_Pad1.05x0.95mm_HandSolder
R304: 0.47; R_0603_1608Metric_Pad1.05x0.95mm_HandSolder

Connections:
+3V3: Q301.3 (C); also elsewhere on the board
BUSY: J301.9; also elsewhere on the board
CS: J301.12; also elsewhere on the board
D-C: J301.11; also elsewhere on the board
EN_VDisplay: R301.1; also elsewhere on the board
GDR: J301.2, Q302.1 (G), R303.1
GND: C301.2, C303.2, C304.2, C305.2, C306.2, C307.2, C308.2, C309.2, C310.2, C311.2, C312.2, D302.1 (K), J301.8, J301.17, R303.2, R304.2; also elsewhere on the board
unnamed: C302.1, D301.1 (K), D302.2 (A)
unnamed: C302.2, D303.2 (A), L301.2, Q302.3 (D)
unnamed: C304.1, J301.4
unnamed: C305.1, J301.5
unnamed: C307.1, J301.18
unnamed: C308.1, J301.19
unnamed: C309.1, J301.20
unnamed: C310.1, J301.22
unnamed: C312.1, J301.24
unnamed: Q301.1 (B), R301.2, R302.2
PREVGH: C303.1, D303.1 (K), J301.21
PREVGL: C311.1, D301.2 (A), J301.23
RES: J301.10; also elsewhere on the board
RESE: J301.3, Q302.2 (S), R304.1
SCLK: J301.13; also elsewhere on the board
SDI: J301.14; also elsewhere on the board
V_Display: C301.1, C306.1, J301.15, J301.16, L301.1, Q301.2 (E), R302.1

Notes on the sheet:
On/Off Displayversorgung
Displayansteuerung

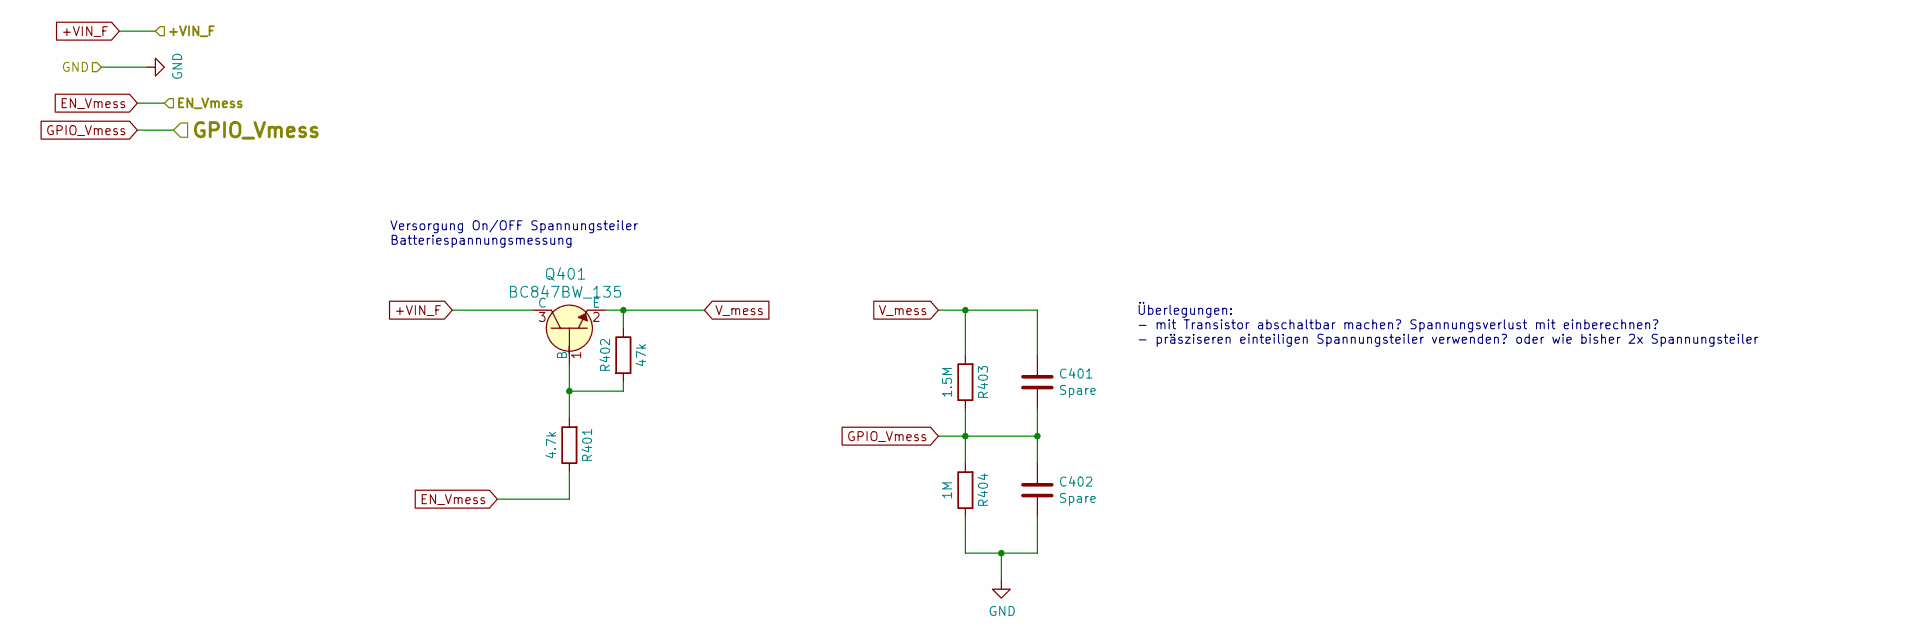
[picture p26: schematic Batterieüberachung.sch]

Parts:
C401, C402: Spare; C_0603_1608Metric
Q401: BC847BW_135; SOT-323_SC-70_Handsoldering; MPN BC847BW,135; Digi-Key_PN 1727-6192-6-ND
R401: 4.7k; R_0603_1608Metric_Pad1.05x0.95mm_HandSolder
R402: 47k; R_0603_1608Metric_Pad1.05x0.95mm_HandSolder
R403: 1.5M; R_0603_1608Metric_Pad1.05x0.95mm_HandSolder
R404: 1M; R_0603_1608Metric_Pad1.05x0.95mm_HandSolder

Connections:
+VIN_F: Q401.3 (C); also elsewhere on the board
EN_Vmess: R401.1; also elsewhere on the board
GND: C402.2, R404.1; also elsewhere on the board
GPIO_Vmess: C401.2, C402.1, R403.1, R404.2; also elsewhere on the board
unnamed: Q401.1 (B), R401.2, R402.2
V_mess: C401.1, Q401.2 (E), R402.1, R403.2

Notes on the sheet:
Versorgung On/OFF Spannungsteiler Batteriespannungsmessung
Überlegungen: - mit Transistor abschaltbar machen? Spannungsverlust mit einberechnen? - präsziseren einteiligen Spannungsteiler verwenden? oder wie bisher 2x Spannungsteiler

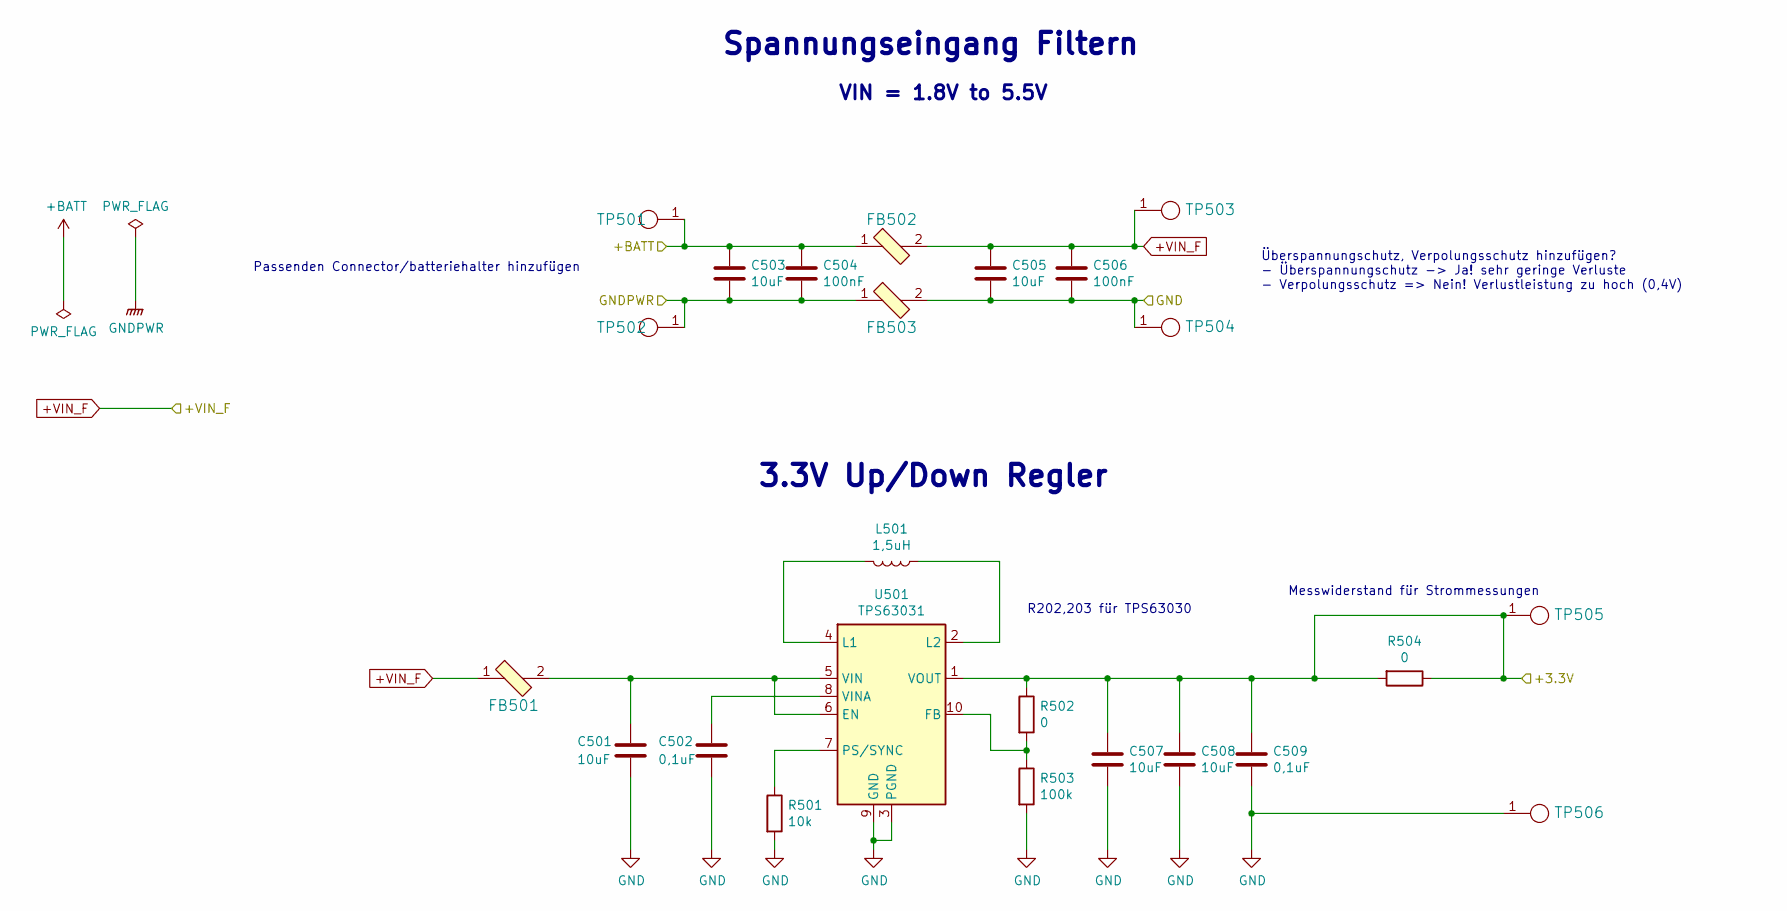
[picture p27: schematic Powere.sch]

Parts:
C501, C507, C508: 10uF; C_0603_1608Metric
C502, C509: 0,1uF; C_0603_1608Metric
C503, C505: 10uF; C_0805_2012Metric_Pad1.15x1.40mm_HandSolder
C504, C506: 100nF; C_0603_1608Metric
FB501, FB502, FB503: 742792641; 0603; MPN 742792641; Digi-Key_PN 732-1592-2-ND
L501: 1,5uH; LPS3015_Coilcraft
R501: 10k; R_0603_1608Metric_Pad1.05x0.95mm_HandSolder
R502, R504: 0; R_0603_1608Metric_Pad1.05x0.95mm_HandSolder
R503: 100k; R_0603_1608Metric_Pad1.05x0.95mm_HandSolder
TP501, TP502, TP503, TP504, TP505, TP506: Testpunkt_small; TestPoint_Pad_D1.5mm
U501: TPS63031; Texas_TPS6303x_ThermalVias

Connections:
+3V3: C507.1, C508.1, C509.1, R502.1, R504.1, R504.2, TP505.1, U501.1 (VOUT); also elsewhere on the board
+BATT: C503.1, C504.1, FB502.1, TP501.1; also elsewhere on the board
+VIN_F: C505.1, C506.1, FB501.1, FB502.2, TP503.1; also elsewhere on the board
GND: C501.2, C502.2, C505.2, C506.2, C507.2, C508.2, C509.2, FB503.2, R501.2, R503.2, TP504.1, TP506.1, U501.3 (PGND), U501.9 (GND), U501.11 (PGND); also elsewhere on the board
GNDPWR: C503.2, C504.2, FB503.1, TP502.1; also elsewhere on the board
unnamed: C501.1, FB501.2, U501.5 (VIN), U501.6 (EN)
unnamed: C502.1, U501.8 (VINA)
unnamed: L501.1, U501.2 (L2)
unnamed: L501.2, U501.4 (L1)
unnamed: R501.1, U501.7 (PS/SYNC)
unnamed: R502.2, R503.1, U501.10 (FB)

Notes on the sheet:
Passenden Connector/batteriehalter hinzufügen
Spannungseingang Filtern
VIN = 1.8V to 5.5V
3.3V Up/Down Regler
Überspannungschutz, Verpolungsschutz hinzufügen? - Überspannungschutz -> Ja! sehr geringe Verluste - Verpolungsschutz => Nein! Verlustleistung zu hoch (0,4V)
R202,203 für TPS63030
Messwiderstand für Strommessungen

Board: 2 copper layers, 78 parts (0 on the bottom side), 50 nets, no tracks yet.
