simonschindler/E-Ink/(commit log)

2019-11-11 Added Hardware
    [E-Ink.kicad_pcb, E-Ink.sch]
2019-11-11 Added ESP32-WROOM-32U to sch-lib
2019-11-11 Added stuff
    [E-Ink.sch]
2019-11-21 safe commit
    [E-Ink.sch]
2019-11-22 Save commit after work at OTH
    [E-Ink.sch]
2019-11-25 save work at oth
    [E-Ink.sch, ESP32_Modul.sch, Powere.sch, Tuerschild_Boarddesign.sch]
2019-11-27 save commit again
    [Batterieüberachung.sch, Displayansteuerung.sch, E-Ink.sch, ESP32_Modul.sch, Powere.sch, Tuerschild_Boarddesign.kicad_pcb, Tuerschild_Boarddesign.sch]
2019-11-27 saving the world
    [E-Ink.sch]
2019-11-29 save commit
    [ESP 32 Modul.sch, IO-Platine.sch, Power.sch]
2019-12-02 save commit from work at night
    [Bestellliste.ods, E-Ink.sch, ESP 32 Modul.sch]
2019-12-02 Save work from OTH
    [Batterieüberwachung.sch, E-Ink.sch, ESP 32 Modul.sch, IO-Platine.sch, Power.sch]
2019-12-05 Martin ist unförmig
    [Batterieüberwachung.sch, Bestellliste.ods, E-Ink.sch, ESP 32 Modul.sch, IO-Platine.sch, Power.sch]
2019-12-09 Konstruktion Frontpanel begonnen.
    [Frontpanel.FCStd]
2019-12-10 Durchführung Flexkabel und Stege für die Platinenhalterung hinzugefügt.
    [Frontpanel.FCStd]
2019-12-12 Ich hoffe wir koennen jetzt den Master mergen!
    [Batterieüberwachung.sch, ESP 32 Modul.sch, IO-Platine.sch, Power.sch]
2019-12-12 Zwischenspeicher Arbeit OTH
    [Batterieüberwachung.sch, E-Ink.sch, ESP 32 Modul.sch, IO-Platine.sch, Power.sch]
2019-12-13 - Ordner "Links" für Teile DigiKey hinzugefügt - Konstruktion Batteriefach.FCStd begonnen - Konstruktion Rückdeckel.FCStd begonnen
    [Batteriefach.FCStd, Rückdeckel.FCStd]
2019-12-13 save work at arges, finished layout and routing
    [Batterieüberwachung.sch, E-Ink.sch, ESP 32 Modul.sch, IO-Platine.sch, Power.sch]
2019-12-17 -Batteriefach: Maße Batteriafach nochmal angepasst + Lage Führung Einschub verändert -Assembly-Datei für groben Zusammenbau eingefügt
    [Assembly.FCStd, Batteriefach.FCStd, Frontpanel.FCStd, Rückdeckel.FCStd]
2019-12-18 -Batteriefach: Position Bohrung verändert -Rückdeckel: Stege Einschub hinzugefügt -Konstruktion: Verriegelungsstift begonnen
    [Assembly.FCStd, Batteriefach.FCStd, Rückdeckel.FCStd, Verriegelungsstift.FCStd]
2019-12-20 finished PCB and ordered
    [E-Ink-B_Cu.gbl, E-Ink-B_Mask.gbs, E-Ink-B_SilkS.gbo, E-Ink-Edge_Cuts.gm1, E-Ink-F_Cu.gtl, E-Ink-F_Mask.gts, E-Ink-F_SilkS.gto, E-Ink.drl]
2020-02-17 Aenderungen Bestellliste begonnen
    [Bestellliste.ods]
2020-02-17 Gehaeusekomponenten hinzugefuegt
    [Bestellliste.ods]
2020-03-10 Batteriefach überarbeitet
    [Batteriefach.FCStd, Batteriefach.step]
2020-03-13 groessere Bohrung Entriegelung
    [Batteriefach.FCStd]
2020-03-20 Rückdeckel: Aufnahme für Kontaktpads hinzugefügt und Einschub an aktuelle Groeße des Batteriefachs angepasstTestfrontpanel und Testrückdeckel für Clipverschluss erstellt
    [Assembly.FCStd, Batteriefach.FCStd, Rückdeckel.FCStd, Testaufbau montiert.FCStd, Testdeckel.FCStd, Testrückdeckel.FCStd, Verriegelungsstift.FCStd]
2020-04-28 Step-Dateien für Druck exportiert.
    [Testdeckel.step, Testrückdeckel.step]
2020-05-02 Rückdeckel um Clips erweitert; Frontpanel um Durchführung für Clips erweitert; Stepdateien für Druck und Fräse exportiert
    [Frontpanel.FCStd, Frontpanel.step, Rückdeckel.FCStd, Rückdeckel.step, Testaufbau montiert.FCStd, Verriegelungsstift.FCStd, Verriegelungsstift.step]
2020-07-03 Auflage für das Display nochmals angepasst, da zu klein
    [Frontpanel.FCStd, Frontpanel.step]
2020-07-10 Save work at Arges
    [Batterieüberwachung.sch, E-Ink.kicad_pcb, E-Ink.sch, ESP 32 Modul.sch, Errata_Platine.xlsx, IO-Platine.sch, Power.sch]
2020-10-20 Added new MCU and redesigned schematics
    [Batterieüberwachung.sch, E-Ink.sch, ESP 32 Modul.sch, IO-Platine.sch, Power.sch]
2020-10-20 finished PCB, Thursday Review with Lukas
    [Batterieüberwachung.sch, E-Ink.kicad_pcb, E-Ink.sch, ESP 32 Modul.sch, IO-Platine.sch]
2020-12-18 restart Hardware
    [Batteriefach.step, Frontpanel.step, Rückdeckel.step, Verriegelungsstift.step]
2020-12-18 added glascover and holding system
    [Glasabdeckung.FCStd, Wandhalterung.FCStd, Wandhalterung_Front.FCStd]
2020-12-21 renaming and small change to glasabdeckung.fcstd
    [Batteriefach.step, Frontpanel.step, Glasabdeckung.FCStd, Rückdeckel.step, Testdeckel.step, Testrückdeckel.step, Verriegelungsstift.step, Wandhalterung_Buchse.FCStd]
